RodBot9999/roderic-systems-roadlink/docs/ARCHITECTURE.md

# Roderic Systems RoadLink Architecture

ESP32 automotive CAN/GPS/OBD scanner with a 2.4-inch SPI TFT, A7670SA cellular telemetry, and a separate local Wi-Fi firmware update service.

## Required Arduino libraries

- **ESP32 by Espressif Systems** board package.
- **mcp_can** by Cory J. Fowler for the MCP2515.
- **Adafruit GFX Library**.
- **Adafruit ILI9341**.
- `WiFi.h`, `WebServer.h`, and `SPI.h` are included with the ESP32 board package.

## Confirmed hardware mapping

| Function | ESP32 GPIO |
|---|---:|
| Encoder CLK | 25 |
| Encoder DT | 26 |
| Encoder button | 27 |
| GPS PPS | 34 |
| GPS TX -> ESP32 RX | 35 |
| GPS RX <- ESP32 TX | 32 |
| ESP32 TX -> A7670SA RX | 16 |
| ESP32 RX <- A7670SA TX | 17 |
| MCP2515 CS | 23 |
| MCP2515 SO / shared MISO | 19 |
| MCP2515 SI / shared MOSI | 18 |
| MCP2515 / TFT shared SCK | 5 |
| MCP2515 INT | 4 |
| TFT CS | 12 |
| TFT DC | 14 |
| TFT RESET | 15 |

The TFT and MCP2515 share SCK, MOSI, and MISO. Each device has a separate CS pin, so only the selected SPI peripheral drives the bus.

GPIO12 and GPIO14 are the confirmed working TFT control pins on the assembled unit. Earlier GPIO22/GPIO21 assignments caused unresolved hardware behavior and are no longer used.

The TFT is configured as a 320x240 landscape ILI9341 display. Its LED/backlight pin is treated as external hardware and is not driven by an ESP32 GPIO in this firmware.

The A7670SA uses only power, ground, and the two UART signals. Reset,
sleep/DTR, and PWRKEY are not connected to the ESP32 and are not driven by the
firmware.

## Carrier PCB design

The RoadLink PCB was created to turn the prototype into one organized vehicle
interface instead of leaving the ESP32 and peripheral modules connected by
loose bench wiring. It acts as a carrier and interconnect board for the ESP32
development module, CAN interface, display, GPS receiver, rotary input, and
cellular modem.

The board-level design follows several practical constraints:

- The TFT and MCP2515 share one SPI bus to conserve ESP32 pins. Independent
  chip-select lines prevent both peripherals from driving the bus together.
- GPS and A7670SA are assigned separate hardware UARTs so serial traffic can be
  processed independently.
- CAN interrupt, GPS PPS, encoder signals, and display control lines remain
  dedicated rather than multiplexed.
- Local bulk capacitance and short power paths support transient loads, but the
  A7670SA still requires a correctly regulated external supply and appropriate
  UART level handling.
- The confirmed GPIO table documents the assembled PCB revision. It
  intentionally replaces earlier experimental assignments that behaved
  unreliably on the physical build.

The carrier is a development prototype, not an automotive-qualified ECU.
Permanent vehicle installation would additionally require appropriate input
protection, load-dump and reverse-polarity protection, environmental testing,
an enclosure, and validated connectors.

## Startup sequence

1. The TFT initializes on the shared custom SPI bus.
2. The uploaded 320x240 `RODERIC SYSTEMS / CAN DIAGNOSTICS` splash is drawn from a compact 2-bit image stored in flash and remains visible until the encoder is pressed.
3. After the press, a live system-check screen reports:
   - rotary input;
   - UI core;
   - GPS receiver UART;
   - OBD service;
   - MCP2515 CAN controller;
   - A7670SA modem.
4. The MCP2515 initializes before the optional modem UART. CAN failures are
   registered as errors, while missing GPS or SIM modules are warnings.
5. The optional-module probe is bounded and can be skipped with an encoder
   press, so disconnected hardware cannot trap startup.
6. When checks finish, the diagnostics screen remains visible for three
   seconds. Pressing the encoder skips the remaining delay.
7. The normal tree menu opens. If diagnostics contain errors or warnings, the
   module-status menu retains the existing override option.

`GPS RECEIVER DETECTED` means serial bytes arrived during the startup probe.
Satellite fix quality remains a separate live GPS status.

## Permanent navigation rule

The interface remains a folder/tree controlled by one rotary encoder:

- Rotate left/right: move the selection.
- Press: enter or activate.
- Every submenu and detail screen contains an explicit `< Back` option.

## Rendering architecture

`MenuSystem` builds a canonical `UiFrame` for the TFT. Remote configuration
updates the underlying settings model; it does not duplicate the menu screen:

```text
CAN / OBD / GPS services
          |
          v
      MenuSystem
          |
          v
       UiModel
          |
          v
     TFT renderer
```

### `TftRenderer`

- uses Adafruit ILI9341 + Adafruit GFX;
- renders in 320x240 landscape;
- uses a black/cyan industrial-cyber visual language;
- renders complete menu lists with a selection bar and scrollbar;
- renders data as compact two-column field cells;
- keeps detail pages fixed until the rotary encoder selects another page;
- shows the currently selected detail action in the footer;
- redraws only when the `UiModel` revision or TFT detail page changes;
- converts unsupported UTF-8 symbols such as degree marks into ASCII-friendly labels.

### Splash storage

`SplashImage.h` stores the uploaded four-color PNG as a packed 2-bit-per-pixel image:

- original image: 320 x 240;
- packed pixel data: 19,200 bytes;
- palette: four RGB565 colors;
- no PNG decoder or SD card is required at boot.

## Main menu tree

```text
Scan-Track-Log
├── CAN Tools
│   ├── CAN Status
│   ├── Passive Monitor
│   │   ├── Live Frame
│   │   ├── ID Browser
│   │   └── Back
│   ├── OBD-II Scanner
│   │   ├── OBD Status
│   │   ├── Discover ECUs
│   │   ├── Live Data
│   │   ├── Supported PIDs
│   │   ├── Read DTCs
│   │   ├── Clear DTCs
│   │   ├── Read VIN
│   │   └── Back
│   ├── Bus Statistics
│   ├── Clear CAN Statistics
│   ├── Retry CAN Controller
│   └── Back
├── GPS Tools
│   ├── Overview
│   ├── Position
│   ├── Fix / Signal
│   ├── Motion
│   ├── Time / Date
│   ├── NMEA Statistics
│   ├── Raw NMEA
│   ├── Reset GPS Statistics
│   └── Back
├── A7670SA / Cellular
│   ├── Status / diagnostics
│   ├── Errors / failure details
│   ├── Enable / disable modem checks
│   ├── START / STOP telemetry
│   ├── Data to send
│   │   ├── GPS telemetry
│   │   ├── OBD-II telemetry
│   │   └── Back
│   ├── Receiver IP / port
│   ├── Access key
│   ├── Send telemetry now
│   ├── Send interval
│   ├── Reconnect modem
│   └── Back
├── Reboot (confirmation, UART modem reset + ESP32 restart)
└── Settings
    ├── CAN Bitrate
    ├── CAN Operating Mode
    ├── Serial CAN Stream
    ├── Serial UI Mirror
    ├── UI Refresh
    ├── OBD Poll Interval
    ├── About
    └── Back
```

Detail screens containing more than ten fields never advance on a timer. Rotate
the encoder to move between pages and press to return. The receiver IP, port,
and key editors also use explicit selection: rotate to choose a digit, press to
edit it, rotate through `0`-`9`, and press again to finish that digit. Rotating
past the digits exposes `SAVE CHANGES` and `CANCEL / BACK`.

## Local firmware updates

`LocalFirmwareUpdateService` owns the only ESP32 Wi-Fi access point. It uses a
device-specific `RoadLink-OTA-XXXXXX` SSID and a persistent, unique password.
The authenticated upload page at `http://192.168.4.1/update` writes to the
inactive OTA application partition. This service does not host a phone UI or
WebSocket dashboard, and it does not use the A7670SA or cellular data. See the
[Local Firmware Update guide](../firmware/RoadLink/LOCAL_FIRMWARE_UPDATE.md).

## CAN and OBD-II architecture

`CanService` owns the MCP2515 receive/transmit paths, frame statistics, identifier browser, diagnostic response queue, and guarded bidirectional transmission.

`ObdService` is a non-blocking standard 11-bit ISO 15765-4 OBD-II state machine supporting ECU discovery, live PIDs, supported-PID masks, stored DTCs, DTC clearing confirmation, VIN, and ISO-TP multi-frame assembly.

The controller still boots in Listen-only mode. Active OBD functions switch it to Normal mode because standardized requests require transmission.

## File responsibilities

### `RoadLink.ino`
Composition root, TFT boot sequence, system checks, service initialization, and non-blocking update loop.

### `AppConfig.h`
Physical pins, TFT rotation/frequency, cellular defaults, queue sizes, and timing defaults.

### `TftRenderer.*`
ILI9341 renderer, splash drawing, startup checks, menu/data/alert layouts, field pagination, and revision-based updates.

### `SplashImage.h`
Packed 2-bit version of the uploaded 320x240 splash image.

### `UiModel.*`
Canonical renderer-independent screen state and optional Serial mirror.

### `LocalFirmwareUpdateService.*`
Authenticated local-Wi-Fi firmware upload, isolated from CAN, GPS, modem,
streaming, and menu services.

### `MenuSystem.*`
Tree navigation, screen definitions, actions, settings, and conversion of service snapshots into `UiFrame` objects.

### `CanService.*`, `ObdService.*`, `GpsService.*`, `EncoderInput.*`
Hardware and protocol services, independent of the active renderer.

### `A7670Service.*`
Non-blocking A7670SA initialization, LTE registration/PDP status, HTTP POST
state machine, and JSON serialization of the existing GPS and OBD-II snapshots.

`SettingsStore` persists the runtime receiver IPv4 address, TCP port, six-digit
access key, check-enable state, and interval in ESP32 NVS. Telemetry-running
state is volatile and starts false on every boot/re-enable/reconnect. The
receiver URL is assembled only inside `A7670Service`; there is no alternate
compiled tunnel endpoint.

It also persists independent GPS and OBD-II payload-selection flags. SIM
controls are a first-level main-menu branch, with a separate status screen,
configuration actions, and checkbox-style telemetry selection.

Warm enable preserves and queries the externally powered modem's existing
radio, operator, registration, attachment, APN, and LTE default bearer. Normal
LTE searching polls without recording a failed AT command each time. The
HTTP state machine is gated by explicit START; STOP settles pending AT/data
input and terminates its HTTP service without launching another POST.

The confirmed main-menu Reboot requests a bounded UART software modem reset
and ESP32 restart. It never claims to electrically reset unconnected devices.

Startup owns a bounded optional-module probe before `MenuSystem::begin()`.
GPS presence is based on received UART bytes; A7670SA presence is based on a
successful `AT` response. Missing optional modules are recorded as warnings.
Only after the timed diagnostics display finishes is the first menu frame
published, preventing the boot renderer from being left on the check screen.

## Recommended first TFT test

1. Install Adafruit GFX and Adafruit ILI9341 in Library Manager.
2. Confirm TFT VCC/GND/backlight wiring before powering.
3. Compile and upload.
4. Verify the splash fills the display in landscape orientation and waits for an encoder press.
5. Confirm the startup-check screen updates CAN and modem status, then opens the first page after three seconds or immediately when pressed.
6. Rotate and press the encoder through every menu.
7. Verify menu navigation and setting persistence on the TFT.
8. If the TFT appears rotated or inverted, change `AppConfig::TFT_ROTATION` between `1` and `3`.

## Validation status

The firmware is intended for the Espressif ESP32 Arduino core and the documented
libraries. Final validation still depends on the physical PCB, exact A7670SA
breakout revision, power supply, UART wiring, cellular network, and target
vehicle.
