RodBot9999/roderic-systems-roadlink/docs/GETTING_STARTED.md

# Getting Started

## Required software

- Arduino IDE 2.x
- ESP32 board package by Espressif Systems
- `mcp_can` by Cory J. Fowler
- Adafruit GFX Library
- Adafruit ILI9341

`WiFi.h`, `WebServer.h`, and `SPI.h` are supplied by the ESP32 board package.

## Confirmed GPIO mapping

| Function | ESP32 GPIO |
|---|---:|
| Encoder CLK | 25 |
| Encoder DT | 26 |
| Encoder button | 27 |
| GPS PPS | 34 |
| ESP32 TX to A7670SA RX | 16 |
| ESP32 RX from A7670SA TX | 17 |
| GPS TX -> ESP32 RX | 35 |
| GPS RX <- ESP32 TX | 32 |
| MCP2515 CS | 23 |
| Shared SPI MISO | 19 |
| Shared SPI MOSI | 18 |
| Shared SPI SCK | 5 |
| MCP2515 INT | 4 |
| TFT CS | 12 |
| TFT DC | 14 |
| TFT RESET | 15 |

GPIO12 and GPIO14 are the confirmed working TFT control pins on the assembled unit. Earlier GPIO22/GPIO21 experiments caused unresolved hardware behavior and are not used by the current firmware.

The TFT and MCP2515 share SCK, MOSI, and MISO. Each device has its own chip-select pin.

The GPIO table follows the assembled RoadLink carrier PCB. It is not a generic
ESP32 wiring suggestion: the TFT control pins and custom MCP2515 SPI mapping
were selected from the connections verified on the physical prototype.

The A7670SA connection is UART-only. Its reset, sleep/DTR, and PWRKEY pins are
not connected to the ESP32, so the firmware never attempts a hardware reset or
sleep transition.

## Uploading

1. Clone or download the repository.
2. Open `firmware/RoadLink/RoadLink.ino`.
3. Install any missing libraries through Arduino Library Manager.
4. Select the ESP32 board that matches the installed hardware.
5. Select the correct serial port.
6. Verify/compile before uploading.
7. Upload and open Serial Monitor at `115200` baud.

Before cellular testing, configure `SIM_APN` in `AppConfig.h` if the SIM/modem
does not already provide a working default APN. Start the
desktop monitor, then enter its displayed public IP, port, and access key under
the main-menu `A7670SA / Cellular` page; RoadLink saves them in NVS. Each value
is edited digit by digit: press a selected digit to change it, press again to
return to digit selection, then choose `SAVE CHANGES`.
Wait for status checks to complete and select green `START` to send telemetry.
Boot and re-enable send no HTTP requests. `STOP` prevents further posts.
Disabling checks does not remove power from the modem. Main-menu `Reboot`
requests a UART modem reset and repeats ESP32 startup, retaining settings but
leaving telemetry stopped.

The startup diagnostics wait a bounded interval for GPS serial bytes and an
enabled A7670SA AT response. Missing modules produce overridable warnings.
`OVERRIDE AND CONTINUE` is initially selected so one press proceeds.

## Expected startup

1. A full-screen Roderic Systems splash appears.
2. Press the rotary encoder to continue.
3. The display reports rotary input, UI, GPS, OBD, CAN, and modem status.
4. The completed status page advances after three seconds or immediately when the encoder is pressed.
5. If CAN initialization fails, RoadLink opens the module-error screen with an override option.

## Local firmware update access point

After the OTA-capable firmware is first uploaded over USB, it creates a
`RoadLink-OTA-XXXXXX` Wi-Fi network for firmware uploads only. Its unique
password is printed at 115200 baud on Serial Monitor and stored separately in
NVS. The authenticated upload page is `http://192.168.4.1/update`; there is
no phone dashboard or WebSocket service at the root address. See the
[Local Firmware Update guide](../firmware/RoadLink/LOCAL_FIRMWARE_UPDATE.md).

## First hardware checks

- Confirm common ground between every module.
- Confirm the TFT power and backlight requirements for the exact display clone.
- Confirm the MCP2515 oscillator and CAN bitrate configuration.
- Test the device away from active driving.
- Begin with CAN listen-only mode.
- If the display is inverted, change `TFT_ROTATION` between `1` and `3`.

## Troubleshooting

### Backlight on, no image

Check TFT controller compatibility, CS `GPIO12`, DC `GPIO14`, RESET `GPIO15`, shared SPI wiring, and ground.

### CAN initialization error

Check MCP2515 power, CS `GPIO23`, INT `GPIO4`, SPI wiring, oscillator selection, and the configured bitrate.

### Firmware update page unavailable

Confirm the computer is connected to `RoadLink-OTA-XXXXXX` and open
`http://192.168.4.1/update`. If the network is absent, check the Serial
Monitor's `[OTA]` messages and verify the board uses an OTA-capable partition.

### A7670SA does not register

Check the SIM card, LTE antenna, carrier LTE coverage, APN, UART direction,
common ground, and module power supply. Use the voltage and current capacity
specified for the exact A7670SA breakout board; do not power it from an ESP32
GPIO or assume the ESP32 3.3 V regulator is sufficient.

Before running the full firmware, use the standalone
[A7670SA baud scanner and AT terminal](../tools/A7670SA_Baud_Terminal/README.md)
to verify the modem's UART rate and `AT` response.
A modem should answer plain `AT` even without a SIM card. Confirm that ESP32
GPIO16 transmits to A7670SA RX and that A7670SA TX drives ESP32 GPIO17. Never
apply the modem power rail to an ESP32 GPIO.
