RodBot9999/roderic-systems-roadlink/Case/acrylic-version/photos/assembled-case-underside.jpg

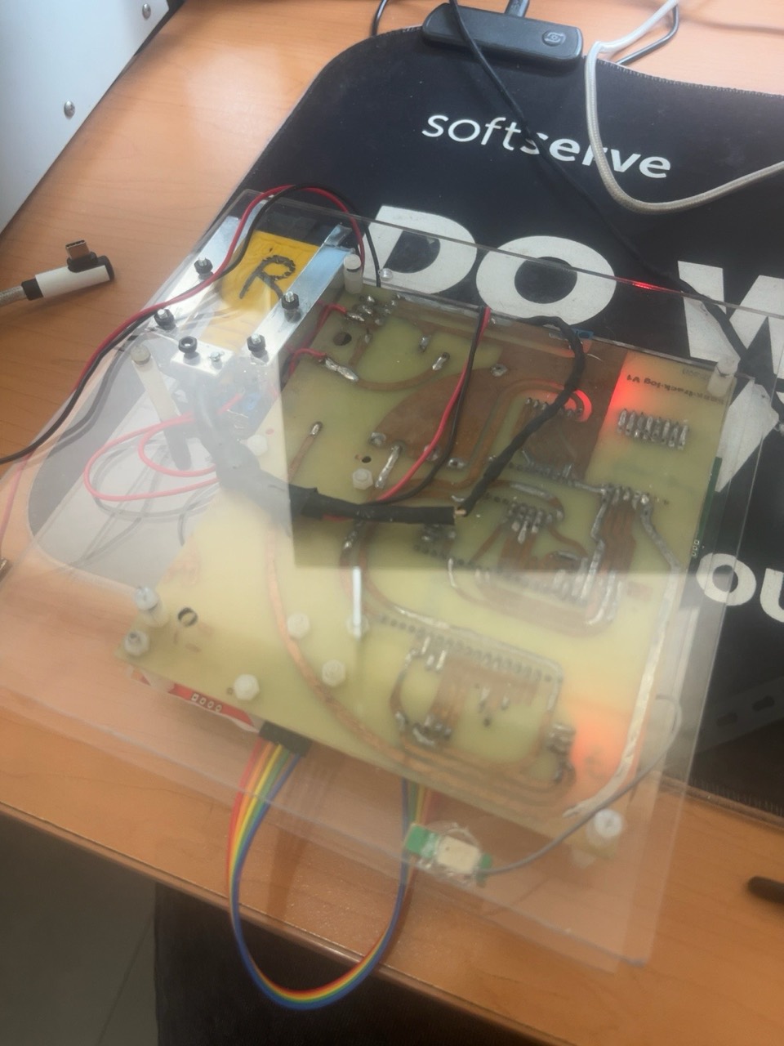
Case/acrylic-version/photos/assembled-case-underside.jpg
