RodBot9999/roderic-systems-roadlink/(commit log)

2026-07-24 Polish PCB design overview
2026-09-26 Add acrylic case bottom cut diagram
2026-09-29 Document RoadLink power interface
2026-09-30 Add OBD-II connector photo to CAN report
2026-09-30 Add finished acrylic case photos
2026-10-19 Consolidate RoadLink documentation and case assets
